Columbia-University-ZMBBI-AIC/LSD8-HW/README.md

# LSD8-HW
LED Synchronous Driver Hardware
