Columbia-University-ZMBBI-AIC/LSD8-HW/LEDSyncDRVG2-BOM_REVA.xlsx

 | REVA | LED Sync. Driver 8 Channels GEN2 |  | 2021-02-08
Qty | MPN | MNF | Parts | VALUE | DESCRIPTION | Package | CURRENT | POWER | TOLERANCE | VOLTAGE | VENDOR | Notes | DATASHEET
32 | 06035C104JAT2A | AVX | C1, C2, C3, C12, C13, C14, C18, C20, C101, C102, C103, C104, C108, C109, C201, C202, C203, C204, C208, C209, C301, C302, C303, C304, C308, C309, C401, C402, C403, C404, C408, C409 | 0.10uF | Multilayer Ceramic Capacitor (MLCC)X7R 0603, 0.10uF 5%, 50V | MLCC_0603 |  |  | 5% | 50V | Mouser |  | https://www.mouser.com/datasheet/2/40/X7RDielectric-777024.pdf
2 | VJ0603D100JXPAJ | Murata | C15, C16 | 10pF | Multilayer Ceramic Capacitor (MLCC)C0G HF 0603, 10pF 5%, 250V | MLCC_0603 |  |  | +/-0.05pF | 250V | Mouser |  | https://www.mouser.com/datasheet/2/427/vjhifreq-1391225.pdf
5 | GMK316AB7106KL-TR | TAIYO YUDEN | C4, C105, C205, C305, C405 | 10uF | Ceramic Capacitor X7R 1206 35V 10uF | MLCC_1206 |  |  |  | 35V | Mouser |  | https://componentsearchengine.com/Datasheets/1/TMK316AB7106KLHT.pdf
3 | CGA3E1X7R1V105K080AC | TDK | C5, C6, C17 | 1uF | Multilayer Ceramic Capacitor (MLCC)X7R 0603, 1uF 10%, 35V | MLCC_0603 |  |  | 10% | 35V | Mouser |  | https://www.mouser.com/datasheet/2/400/lcc_automotive_general_en-843974.pdf
1 | GCM1885C2A470FA16D | Murata | C7 | 47pF | Multilayer Ceramic Capacitor (MLCC)C0G HF 0603, 47pF 1%, 100V | MLCC_0603 |  |  | 1% | 100V | Mouser |  | https://psearch.en.murata.com/capacitor/lineup/gcm/?excid=ww_pa-o_ow_ctl_c02e-21_2017#a01
13 | 0603ZD106KAT2A | AVX | C8, C9, C10, C11, C19, C106, C107, C206, C207, C306, C307, C406, C407 | 10uF | Multilayer Ceramic Capacitor (MLCC)X5R 0603, 10uF 10%, 10V | MLCC_0603 |  |  | 10% | 10V | Mouser |  | https://www.mouser.com/datasheet/2/40/cx5r-776519.pdf
1 | MMSZ3V6T1G | ON Semi | D1 | 3.6V | ZENNER DIODE, 0.5W, 3.6V, SMT SOD123-2 | SOD3716X135N_DIODE | 100mA | 0.5W max |  |  | Mouser |  | https://www.mouser.com/datasheet/2/308/MMSZ2V4T1-D-87271.pdf
1 | NHP140SFT3G | ON Semi | D2 | NHP140 | Rectifier Diode 1A 400V. SOD−123FL | SOD-123FL | 1A | 330 degC/W |  |  | Mouser |  | https://www.onsemi.com/pub/Collateral/NHP140SF-D.PDF.pdf
1 | AP63200WU-7 | Diodes Inc. | IC1 | AP63200 | Switching Voltage Regulators DCDC Conv HV Buck TSOT26 | SOT95P280X100-6N |  |  |  |  | Mouser
12 | TLV2197QDGKRQ1 | Texas Instruments | IC101, IC104, IC105, IC201, IC204, IC205, IC301, IC304, IC305, IC401, IC404, IC405 | TLV2197 | 36-V, Single-Supply, 10-MHz, Rail-to-Rail IN&Output, Dual Operational Amplifier | VSSOP8-DGK-065P |  |  |  |  | Mouser |  | https://www.ti.com/lit/ds/symlink/tlv197-q1.pdf?ts=1595483432163
1 | TLV76733DGNR | TI | IC2 | TLV76733 | Precision Linear Voltage Regulator FIX 3.3V 1A 16V max in Drop 1.5V VSSOP PAD | VSSOP8-DGK-065P |  |  |  |  | Mouser |  | https://www.ti.com/lit/ds/symlink/tlv767.pdf?ts=1612309893782
10 | TC7WZ08FK | Toshiba | IC3, IC5, IC102, IC103, IC202, IC203, IC302, IC303, IC402, IC403 | TC7WZ08 | Logic Gates Dual AND in TSSOP | SOP50P310X90-8N |  |  |  |  | Mouser |  | https://toshiba.semicon-storage.com/info/docget.jsp?did=54672&prodName=TC7WZ08FK
1 | STM32F410CBT3 | STMicroelectronics | IC4 | STM32F410 | MCU STM32F410 Cortex M4 125DMips 128KBFlash, 32KB Ram, ADC/DAC, LQFP48 | QFP50P900X900X160-48N |  |  |  |  | Mouser |  | https://www.mouser.com/datasheet/2/389/stm32f410cb-1851313.pdf
1 | VLS5045EX-100M | TDK | L1 | 10uH | TDK VLS-EX Series Type 5045 Shielded Wire-wound SMD Inductor with a Ferrite Core, 10 uH Wire-Wound 2.5A Idc | IND_5X5MM-5045 |  |  |  |  | Mouser |  | https://componentsearchengine.com/Datasheets/1/VLS5045EX-100M.pdf
1 | CFM100M075 | Cincon | M1 | 7.5V 13.4A PS | OPEN FRAME 3X5 AC-DC PS MODULE WITH PFC ,100W MEDICAL&ITE, 7.5V 13.4A" | PS_5X3_MOLEX8P |  |  |  |  | Mouser |  | https://www.cincon.com/productdownload/SPEC-CFM100M-V19.pdf
8 | DMG6601LVT-7 | Diodes | Q101, Q102, Q201, Q202, Q301, Q302, Q401, Q402 | DMG6601 | Diodes Inc DMG6601LVT-7 Dual N/P-channel MOSFET, 2 A, 3A, 30 V, 6-Pin TSOT-26 | SOT95P280X100-6N |  |  |  |  | Mouser |  | https://www.diodes.com/assets/Datasheets/DMG6601LVT.pdf
8 | BSC12DN20NS3 G | Infineon | Q103, Q104, Q203, Q204, Q303, Q304, Q403, Q404 | BSC12DN20N | N CH MOSFET 200V, 11.3A, 125mOhm ON, 12S gfs, SMT TDSON-8 | TDSON-8 | 11.3A | 50W |  |  | Mouser |  | https://www.mouser.com/datasheet/2/196/BSC12DN20NS3%20Rev2.2-58027.pdf
1 | CRCW060356K0FKEA | Vishay | R1 | 56 kΩ | Thick Film Resistor 0603, 56 kΩ ,1%, 0.1W | R0603 |  | 0.1W | 1% |  | Mouser |  | http://www.vishay.com/docs/20035/dcrcwe3.pdf
8 | CRCW06034K30FKEA | Vishay | R103, R104, R203, R204, R303, R304, R403, R404 | 4.3 kΩ | Thick Film Resistor 0603, 4.3 kΩ ,1%, 0.1W | R0603 |  | 0.1W | 1% |  | Mouser |  | http://www.vishay.com/docs/20035/dcrcwe3.pdf
16 | CRCW060333R0FKEA | Vishay | R105, R106, R114, R115, R205, R206, R214, R215, R305, R306, R314, R315, R405, R406, R414, R415 | 33 Ω | Thick Film Resistor 0603, 33 Ω ,1%, 0.1W | R0603 |  | 0.1W | 1% |  | Mouser |  | http://www.vishay.com/docs/20035/dcrcwe3.pdf
8 | CRCW06033K30FKEA | Vishay | R107, R108, R207, R208, R307, R308, R407, R408 | 3.3 kΩ | Thick Film Resistor 0603, 3.3 kΩ ,1%, 0.1W | R0603 |  | 0.1W | 1% |  | Mouser |  | http://www.vishay.com/docs/20035/dcrcwe3.pdf
8 | 3006P-7-502LF | Bourns | R109, R110, R209, R210, R309, R310, R409, R410 | 5K | Multi Turn Resistor Long, Through Hole RA 5K 10% 3/4 " | MTBOURNS_RA_LONG |  |  |  |  | Mouser |  | https://www.mouser.com/datasheet/2/54/3006-1649234.pdf
8 | WK73S3A3TTE1R00F | KOA Speer | R116, R117, R216, R217, R316, R317, R416, R417 | 1 Ohm | Thick Film Resistor Reversed 1225 1 ohm 1% 3W | R1225 |  |  |  |  | Mouser |  | https://www.mouser.com/datasheet/2/219/WK73S-1840148.pdf
22 | CRCW060310K0FKEA | Vishay | R2, R4, R6, R10, R11, R12, R101, R102, R111, R112, R201, R202, R211, R212, R301, R302, R311, R312, R401, R402, R411, R412 | 10 kΩ | Thick Film Resistor 0603, 10 kΩ ,1%, 0.1W | R0603 |  | 0.1W | 1% |  | Mouser |  | http://www.vishay.com/docs/20035/dcrcwe3.pdf
4 | CRCW0603100RFKEA | Vishay | R3, R5, R7, R8 | 100 Ω | Thick Film Resistor 0603, 100 Ω ,1%, 0.1W | R0603 |  | 0.1W | 1% |  | Mouser |  | http://www.vishay.com/docs/20035/dcrcwe3.pdf
6 | CRCW06030000Z0EA | Vishay | R9, R13, R113, R213, R313, R413 | 0 Ω | Thick Film Resistor 0603, 0 Ω ,1%, 0.1W | R0603 |  |  |  |  | Mouser |  | http://www.vishay.com/docs/20035/dcrcwe3.pdf
1 | ECS-240-8-33-RWY-TR | ECS | Y1 | 24.0MHz | Crystal 3.2X2.5mm 24MHz 15ppm 8pF -30C +55C | XTAL4P_3.2X2.5MM |  |  |  |  | Mouser |  | https://www.mouser.com/datasheet/2/122/ecx-32-1100709.pdf
1 | 800SP9B6M6RE | E-Switch | S1 | SPST RA | Pushbutton Switch SPST RA PCB With Mounting NON-THD | SITCH_PB_RA_800SP9B6M6RE |  |  |  |  | Mouser |  | https://www.mouser.com/datasheet/2/140/800-345975.pdf
1 | DS03-254-08BE | CUI | S3 | DIP8-RA | DIP Switches SPST, 2.54 pitch, Raised actuator, RA, 8 position, Blue | SWITCHX8_DIP_RA_0.1IN | 25ma |  |  | 24V | Mouser |  | https://www.mouser.com/datasheet/2/670/ds03_254-1777715.pdf
1 | 70555-0072 | Molex | J1 | HDR 1X3 RA-M | Header RA Male 1X3 Gold Shrouded 0.1 " | HDR_1X3RAS | 3A |  |  |  | Mouser |  | https://www.mouser.com/datasheet/2/276/705550071_sd-1608181.pdf
8 | 1526169 | Phoenix | J103, J104, J203, J204, J303, J304, J403, J404 | 4P Thor LED RA | Circular 4 PIN Female RA Thor Led Pinout | CIR_PHX4P_RA |  |  |  |  | Mouser |  | https://www.mouser.com/datasheet/2/324/4/1526169-1415351.pdf
1 | 30310-5002HB | 3M | J2 | HDR 2X5 RA-M | Header RA Male 2X5 Gold Shrouded 0.1 " | HDR_2X5M_RAS | 1A |  |  |  | Mouser | Molex has replacement 70247-1054 | https://www.mouser.com/datasheet/2/1/TS0818-221281.pdf
9 | 5227161-6 | TE | J3, J101, J102, J201, J202, J301, J302, J401, J402 | RA BNC 50 Ohm | BNC R.A. JACK 50 OHM ISOLATED | BNC_AMP_227161 |  |  |  |  | Mouser |  | https://www.te.com/commerce/DocumentDelivery/DDEController?Action=srchrtrv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
2 | 77311-124-02LF | Amphenol FCI | J4, J5 | HDR 1x2 ST-M | Header Straight Male 1 X 2 (2.54mm square) 6.75mm post | HDR_1X2 | 3A |  |  |  | Mouser |  | https://www.mouser.com/datasheet/2/18/77311-1266344.pdf
1 | NHD-3.12-25664UCY2 | Newhaven Display | DS1 | OLED Display Yellow 256X64 | OLED Display 256 x 64 Yellow 89.2 x 44.0 x 6.0 3.0V | DISPLAY20P |  |  |  |  | Mouser |  | https://www.mouser.com/datasheet/2/291/NHD_3_12_25664UCY2-1902151.pdf
1 |  |  | R14 | NP | No Placed/Populated Resistor | R0603
1 |  |  | S2 | NP | Pushbutton Switch SPST RA PCB With Mounting NON-THD | SITCH_PB_RA_800SP9B6M6RE |  |  |  |  | Mouser |  | https://www.mouser.com/datasheet/2/140/800-345975.pdf
3 |  |  | J6,J7,J8 | NP | Header Straight Male 1 X 6 (2.54mm square) 6.75mm post | HDR_1X06 | 3A |  |  |  | Mouser |  | https://www.mouser.com/datasheet/2/18/77311-1266344.pdf
