Columbia-University-ZMBBI-AIC/LSD8-HW/Mechanic/dispBracket.stl

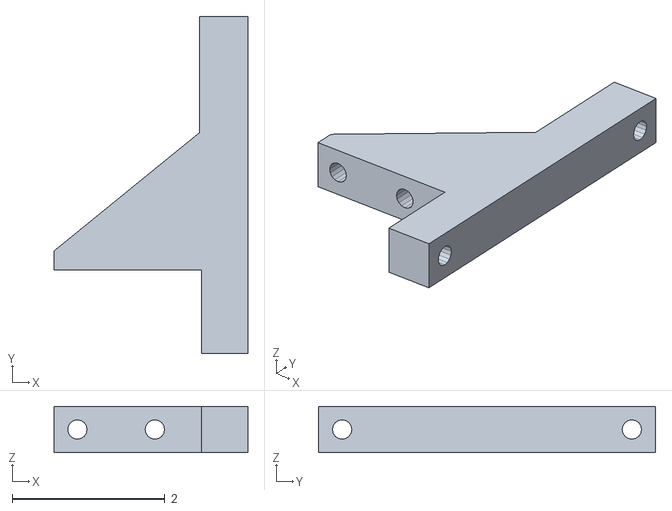
[picture p1: CAD file, 2022-06-25]
Mechanic/dispBracket.stl
2.54 x 4.42 x 0.61
