Columbia-University-ZMBBI-AIC/LSD8-HW/(list of files, cad)

Other CAD files:
Mechanic/dispBracket.ipt
