Columbia-University-ZMBBI-AIC/LSD8-HW/Mechanic/LEDSyncDRVG2-DimAIC00028REVA.pdf

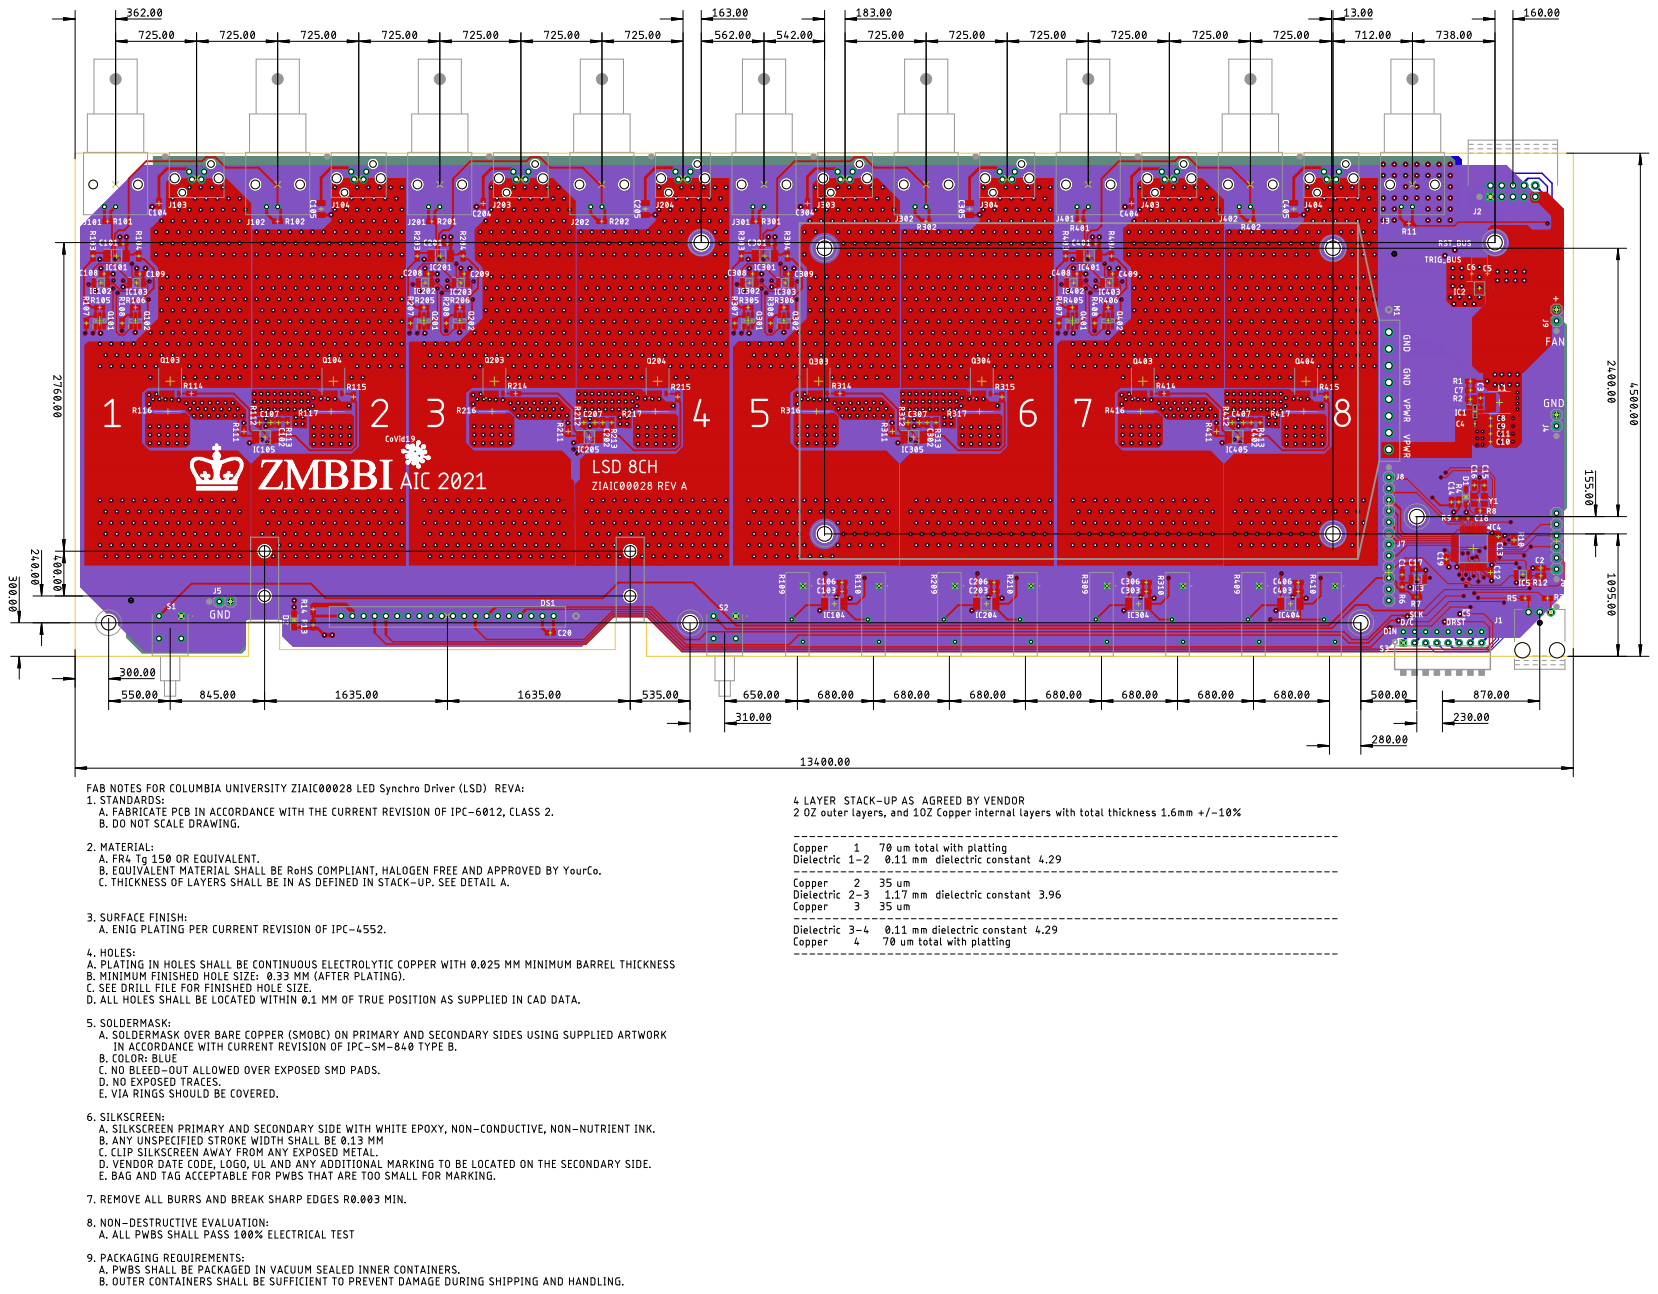
[picture p2: page 1]
