Columbia-University-ZMBBI-AIC/LSD8-HW/LEDSyncDRVG2.brd

## EAGLE design LEDSyncDRVG2.brd (2022-06-25)

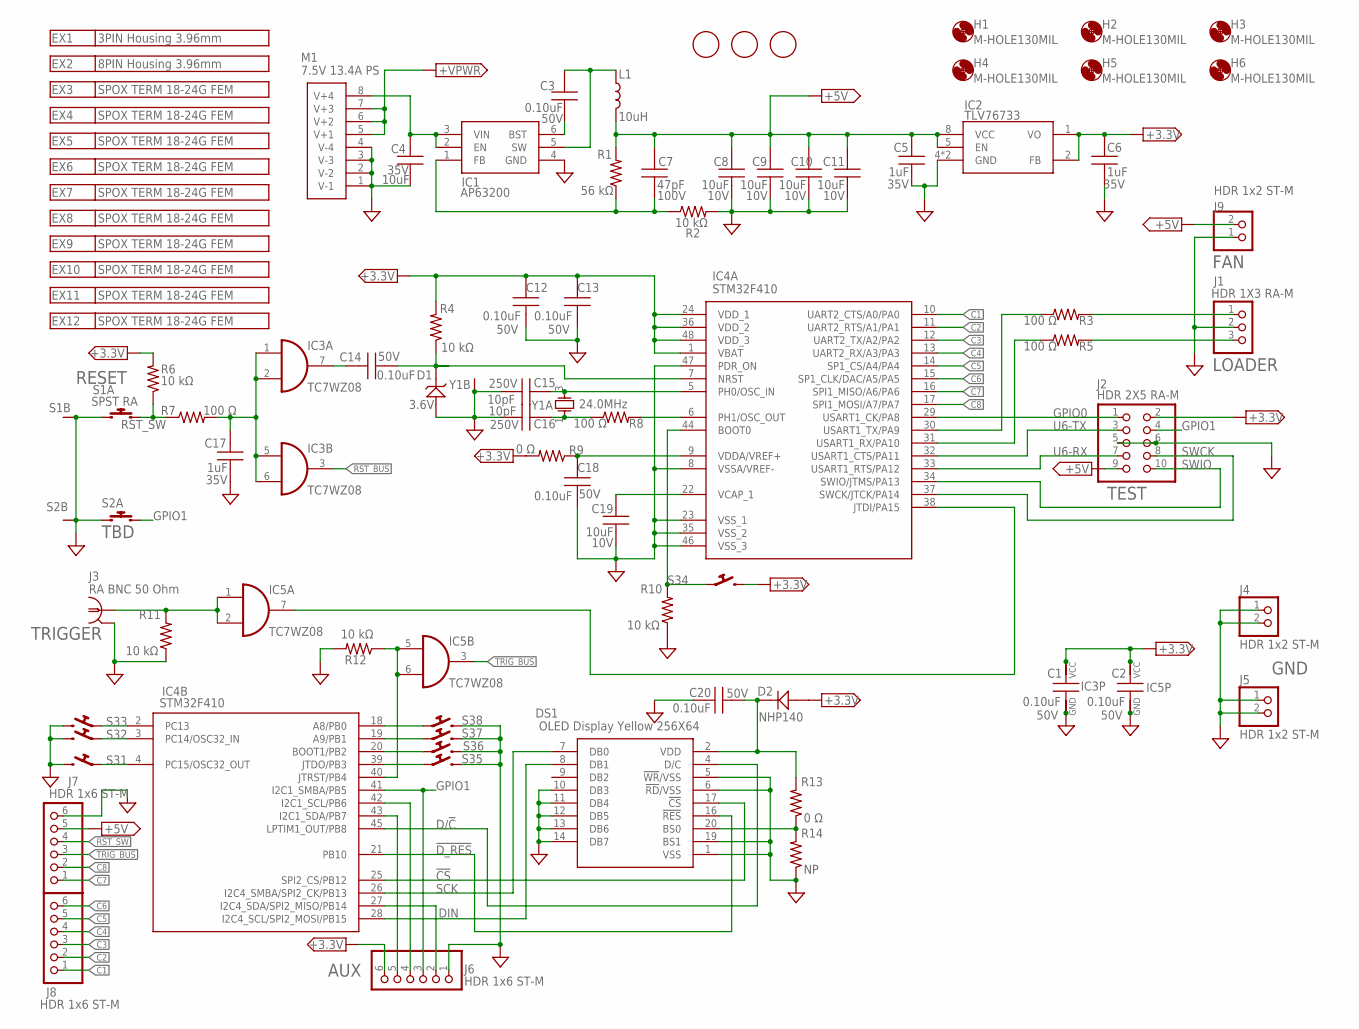
[picture p8: schematic LEDSyncDRVG2.sch, sheet 1]

Parts:
C1, C2, C3, C12, C13, C14, C18, C20: 0.10uF; MLCC_0603
C4: 10uF; MLCC_1206
C5, C6, C17: 1uF; MLCC_0603
C7: 47pF; MLCC_0603
C8, C9, C10, C11, C19: 10uF; MLCC_0603
C15, C16: 10pF; MLCC_0603
D1: 3.6V; SOD3716X135N_DIODE
D2: NHP140; SOD-123FL
DS1: OLED Display Yellow 256X64; DISPLAY20P
H1, H2, H3, H4, H5, H6: M-HOLE130MIL; 4-40_130HOLE_260CLEAR
IC1: AP63200; SOT95P280X100-6N
IC2: TLV76733; VSSOP8-DGK-065P
IC3, IC5: TC7WZ08; SOP50P310X90-8N
IC4: STM32F410; QFP50P900X900X160-48N
J1: HDR 1X3 RA-M; HDR_1X3RAS
J2: HDR 2X5 RA-M; HDR_2X5M_RAS
J3: RA BNC 50 Ohm; BNC_AMP_227161
J4, J5, J9: HDR 1x2 ST-M; HDR_1X2
J6: HDR 1x6 ST-M; HDR_1X06
J7, J8: HDR 1x6 ST-M; HDR_1X06; MPN NP
L1: 10uH; IND_5X5MM-5045
M1: 7.5V 13.4A PS; PS_5X3_MOLEX8P
R1: 56 kΩ; R0603
R2, R4, R6, R10, R11, R12: 10 kΩ; R0603
R3, R5, R7, R8: 100 Ω; R0603
R9, R13: 0 Ω; R0603
R14: NP; R0603
S1, S2: SPST RA; SITCH_PB_RA_800SP9B6M6RE
S3: DIP8-RA; SWITCHX8_DIP_RA_0.1IN
U$1, U$2, U$3: FIDUCIAL; FIDUCIAL_1MM
Y1: 24.0MHz; XTAL4P_3.2X2.5MM

Connections:
!CS: DS1.17 (!CS), IC4.25 (SPI2_CS/PB12)
!D_RES: DS1.16 (!RES), IC4.21 (PB10)
+3.3V: C1.2, C2.2, C6.1, C12.2, C13.2, D2.2 (A), IC2.1 (VO), IC2.2 (FB), IC3.8 (VCC), IC4.1 (VBAT), IC4.24 (VDD_1), IC4.36 (VDD_2), IC4.48 (VDD_3), IC5.8 (VCC), J2.2, J6.6, R4.2, R6.2, R9.2, S3.8; also elsewhere on the board
+5V: C5.1, C7.2, C8.2, C9.2, C10.2, C11.2, IC2.5 (EN), IC2.8 (VCC), J2.9, J7.5, J9.2, L1.2, R1.2; also elsewhere on the board
+VPWR: M1.5 (V+1), M1.6 (V+2), M1.7 (V+3); also elsewhere on the board
C1: IC4.10 (UART2_CTS/A0/PA0), J8.1; also elsewhere on the board
C2: IC4.11 (UART2_RTS/A1/PA1), J8.2; also elsewhere on the board
C3: IC4.12 (UART2_TX/A2/PA2), J8.3; also elsewhere on the board
C4: IC4.13 (UART2_RX/A3/PA3), J8.4; also elsewhere on the board
C5: IC4.14 (SP1_CS/A4/PA4), J8.5; also elsewhere on the board
C6: IC4.15 (SP1_CLK/DAC/A5/PA5), J8.6; also elsewhere on the board
C7: IC4.16 (SPI1_MISO/A6/PA6), J7.1; also elsewhere on the board
C8: IC4.17 (SPI1_MOSI/A7/PA7), J7.2; also elsewhere on the board
D/!C: DS1.4 (D/C), IC4.45 (LPTIM1_OUT/PB8)
DIN: DS1.8 (DB1), IC4.28 (I2C4_SCL/SPI2_MOSI/PB15)
GND: C1.1, C2.1, C4.2, C5.2, C6.2, C8.1, C9.1, C10.1, C11.1, C12.1, C13.1, C15.1, C16.1, C17.2, C18.1, C19.1, C20.2, D1.2 (A), DS1.1 (VSS), DS1.5 (!WR!/VSS), DS1.6 (!RD!/VSS), DS1.10 (DB3), DS1.11 (DB4), DS1.12 (DB5), DS1.13 (DB6), DS1.14 (DB7), DS1.19 (BS1), IC1.4 (GND), IC2.4 (GND), IC2.6 (GND), IC3.4 (GND), IC4.8 (VSSA/VREF-), IC4.23 (VSS_1), IC4.35 (VSS_2), IC4.46 (VSS_3), IC4.47 (PDR_ON), IC5.4 (GND), J1.2, J2.5, J2.6, J3.2, J4.1, J4.2, J5.1, J5.2, J6.1, J7.6, J9.1, M1.1 (V-1), M1.2 (V-2), M1.3 (V-3), M1.4 (V-4), R2.2, R10.1, R11.1, R12.2, R14.1, S1.1, S1.MH1 (G1), S1.MH2 (G1), S2.1, S2.MH1 (G1), S2.MH2 (G1), S3.2, S3.4, S3.6, S3.10, S3.12, S3.14, S3.16, Y1.2 (G1), Y1.4 (G1); also elsewhere on the board
GPIO0: IC4.29 (USART1_CK/PA8), J2.1
GPIO1: IC4.41 (I2C1_SMBA/PB5), J2.4, J6.3, S2.3
unnamed: C4.1, IC1.2 (EN), IC1.3 (VIN), M1.8 (V+4)
unnamed: IC4.6 (PH1/OSC_OUT), R8.2
unnamed: C16.2, R8.1, Y1.1 (IO)
unnamed: C15.2, IC4.5 (PH0/OSC_IN), Y1.3 (OI)
unnamed: C18.2, IC4.9 (VDDA/VREF+), R9.1
unnamed: IC4.3 (PC14/OSC32_IN), S3.3
unnamed: C19.2, IC4.22 (VCAP_1)
unnamed: IC4.44 (BOOT0), R10.2, S3.7
unnamed: C14.1, D1.1 (K), IC4.7 (NRST), R4.1
unnamed: C3.2, IC1.5 (SW), L1.1
unnamed: C7.1, IC1.1 (FB), R1.1, R2.1
unnamed: C3.1, IC1.6 (BST)
unnamed: IC4.18 (A8/PB0), S3.15
unnamed: IC4.19 (A9/PB1), S3.13
unnamed: J1.3, R5.2
unnamed: J1.1, R3.2
unnamed: IC4.20 (BOOT1/PB2), S3.11
unnamed: IC4.39 (JTDO/PB3), S3.9
unnamed: IC4.2 (PC13), S3.5
unnamed: DS1.20 (BS0), R13.1, R14.2
unnamed: IC4.4 (PC15/OSC32_OUT), S3.1
unnamed: IC4.38 (JTDI/PA15), IC5.7 (O)
unnamed: C20.1, D2.1 (K), DS1.2 (VDD), R13.2
unnamed: IC4.27 (I2C4_SDA/SPI2_MISO/PB14), J6.2
unnamed: IC4.30 (USART1_TX/PA9), R3.1
unnamed: IC4.43 (I2C1_SDA/PB7), J6.5
unnamed: IC4.42 (I2C1_SCL/PB6), J6.4
unnamed: C14.2, IC3.7 (O)
unnamed: IC4.31 (USART1_RX/PA10), R5.1
unnamed: IC4.40 (JTRST/PB4), IC5.5 (I0), IC5.6 (I1), R12.1
unnamed: IC5.1 (I0), IC5.2 (I1), J3.1, R11.2
RST: C17.1, IC3.1 (I0), IC3.2 (I1), IC3.5 (I0), IC3.6 (I1), R7.2
RST_BUS: IC3.3 (O); also elsewhere on the board
RST_SW: J7.4, R6.1, R7.1, S1.3
SCK: DS1.7 (DB0), IC4.26 (I2C4_SMBA/SPI2_CK/PB13)
SWCK: IC4.37 (SWCK/JTCK/PA14), J2.8
SWIO: IC4.34 (SWIO/JTMS/PA13), J2.10
TRIG_BUS: IC5.3 (O), J7.3; also elsewhere on the board
U6-RX: IC4.33 (USART1_RTS/PA12), J2.7
U6-TX: IC4.32 (USART1_CTS/PA11), J2.3

Notes on the sheet:
TEST
AUX
LOADER
TRIGGER
GND
RESET
TBD
FAN

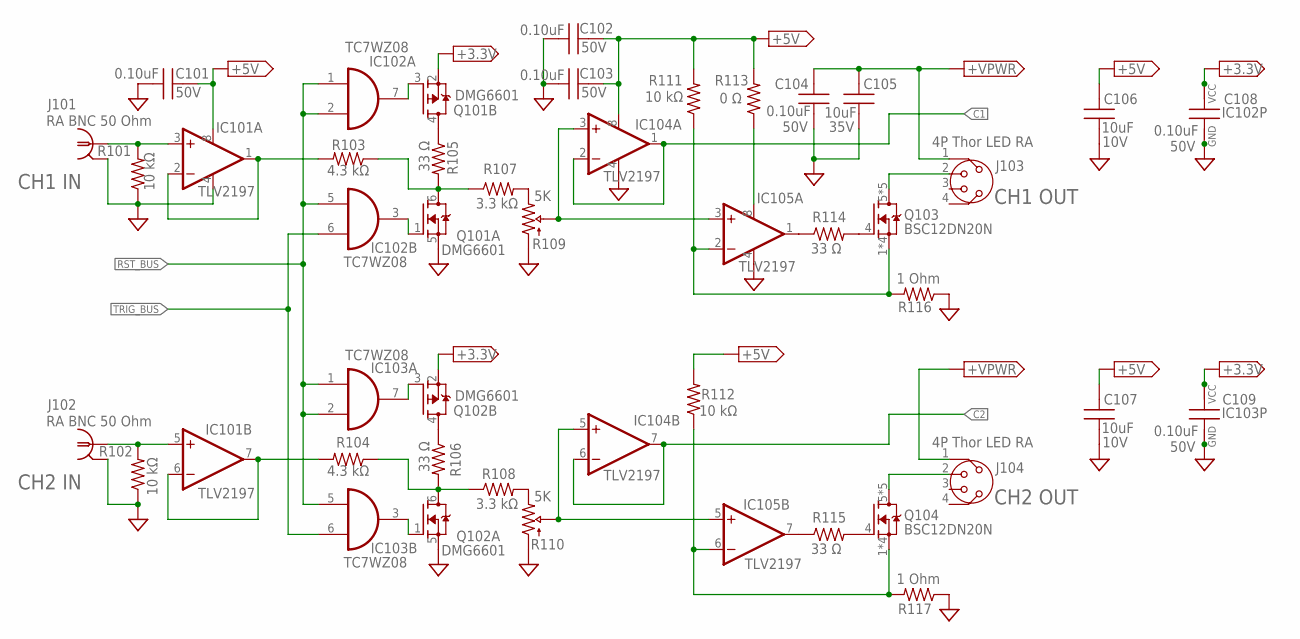
[picture p9: schematic LEDSyncDRVG2.sch, sheet 2]

Parts:
C101, C102, C103, C104, C108, C109: 0.10uF; MLCC_0603
C105: 10uF; MLCC_1206
C106, C107: 10uF; MLCC_0603
IC101, IC104, IC105: TLV2197; VSSOP8-DGK-065P
IC102, IC103: TC7WZ08; SOP50P310X90-8N
J101, J102: RA BNC 50 Ohm; BNC_AMP_227161
J103, J104: 4P Thor LED RA; CIR_PHX4P_RA
Q101, Q102: DMG6601; SOT95P280X100-6N
Q103, Q104: BSC12DN20N; TDSON-8
R101, R102, R111, R112: 10 kΩ; R0603
R103, R104: 4.3 kΩ; R0603
R105, R106, R114, R115: 33 Ω; R0603
R107, R108: 3.3 kΩ; R0603
R109, R110: 5K; MTBOURNS_RA_LONG
R113: 0 Ω; R0603
R116, R117: 1 Ohm; R1225

Connections:
+3.3V: C108.2, C109.2, IC102.8 (VCC), IC103.8 (VCC), Q101.2 (S), Q102.2 (S); also elsewhere on the board
+5V: C101.2, C102.2, C103.2, C106.2, C107.2, IC101.8 (V+), IC104.8 (V+), R111.2, R112.2, R113.2; also elsewhere on the board
+VPWR: C104.2, C105.1, J103.1, J104.1; also elsewhere on the board
C1: IC104.1 (OUT), IC104.2 (-IN); also elsewhere on the board
C2: IC104.6 (-IN), IC104.7 (OUT); also elsewhere on the board
GND: C101.1, C102.1, C103.1, C104.1, C105.2, C106.1, C107.1, C108.1, C109.1, IC101.4 (V-), IC102.4 (GND), IC103.4 (GND), IC104.4 (V-), IC105.4 (V-), J101.2, J102.2, Q101.5 (S), Q102.5 (S), R101.1, R102.1, R109.1 (START), R110.1 (START), R116.1, R117.1; also elsewhere on the board
unnamed: Q102.4 (D), R106.1
unnamed: Q101.4 (D), R105.1
unnamed: Q101.6 (D), R103.1, R105.2, R107.1
unnamed: IC102.3 (O), Q101.1 (G)
unnamed: IC102.7 (O), Q101.3 (G)
unnamed: IC101.1 (OUT), IC101.2 (-IN), R103.2
unnamed: IC101.3 (+IN), J101.1, R101.2
unnamed: R107.2, R109.3 (END)
unnamed: Q102.6 (D), R104.1, R106.2, R108.1
unnamed: IC104.3 (+IN), IC105.3 (+IN), R109.2 (WIPER)
unnamed: IC105.1 (OUT), R114.1
unnamed: IC105.2 (-IN), Q103.1 (S), Q103.2 (S), Q103.3 (S), Q103.10 (S), R111.1, R116.2
unnamed: Q103.4 (G), R114.2
unnamed: IC103.3 (O), Q102.1 (G)
unnamed: J103.2, Q103.5 (D), Q103.6 (D), Q103.7 (D), Q103.8 (D), Q103.9 (D)
unnamed: IC103.7 (O), Q102.3 (G)
unnamed: IC101.5 (+IN), J102.1, R102.2
unnamed: IC101.6 (-IN), IC101.7 (OUT), R104.2
unnamed: R108.2, R110.3 (END)
unnamed: IC104.5 (+IN), IC105.5 (+IN), R110.2 (WIPER)
unnamed: IC105.6 (-IN), Q104.1 (S), Q104.2 (S), Q104.3 (S), Q104.10 (S), R112.1, R117.2
unnamed: IC105.7 (OUT), R115.1
unnamed: Q104.4 (G), R115.2
unnamed: J104.2, Q104.5 (D), Q104.6 (D), Q104.7 (D), Q104.8 (D), Q104.9 (D)
unnamed: IC105.8 (V+), R113.1
RST_BUS: IC102.1 (I0), IC102.2 (I1), IC102.5 (I0), IC103.1 (I0), IC103.2 (I1), IC103.5 (I0); also elsewhere on the board
TRIG_BUS: IC102.6 (I1), IC103.6 (I1); also elsewhere on the board

Notes on the sheet:
CH1 IN
CH2 IN
CH1 OUT
CH2 OUT

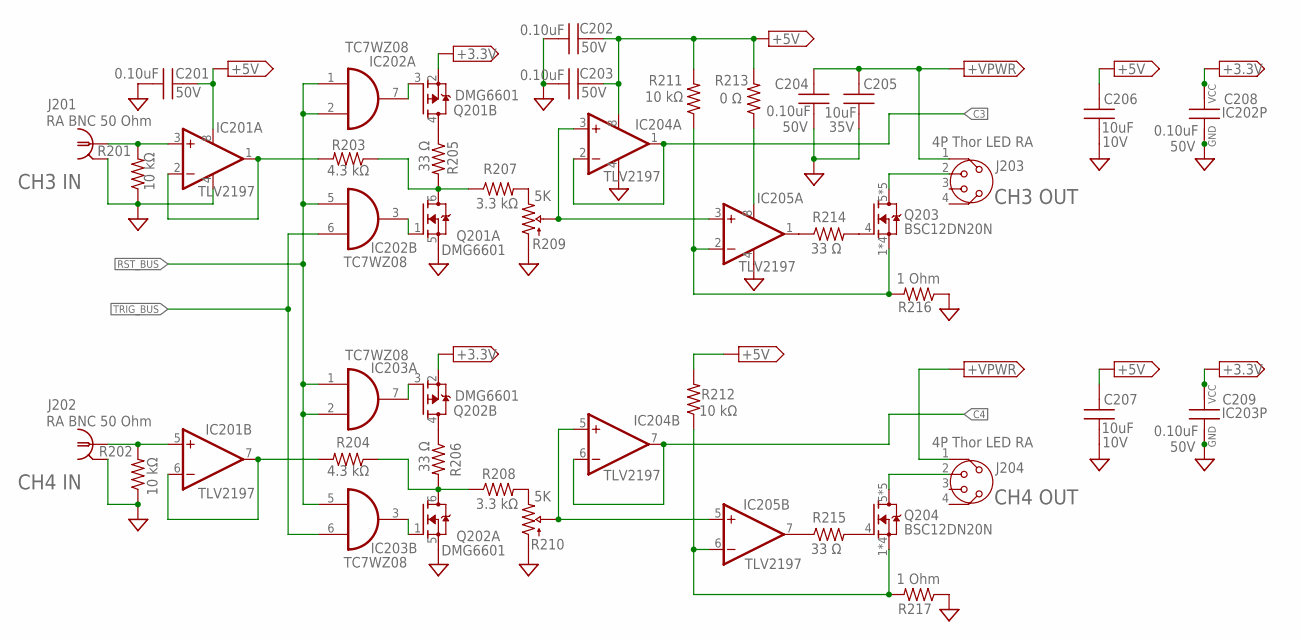
[picture p10: schematic LEDSyncDRVG2.sch, sheet 3]

Parts:
C201, C202, C203, C204, C208, C209: 0.10uF; MLCC_0603
C205: 10uF; MLCC_1206
C206, C207: 10uF; MLCC_0603
IC201, IC204, IC205: TLV2197; VSSOP8-DGK-065P
IC202, IC203: TC7WZ08; SOP50P310X90-8N
J201, J202: RA BNC 50 Ohm; BNC_AMP_227161
J203, J204: 4P Thor LED RA; CIR_PHX4P_RA
Q201, Q202: DMG6601; SOT95P280X100-6N
Q203, Q204: BSC12DN20N; TDSON-8
R201, R202, R211, R212: 10 kΩ; R0603
R203, R204: 4.3 kΩ; R0603
R205, R206, R214, R215: 33 Ω; R0603
R207, R208: 3.3 kΩ; R0603
R209, R210: 5K; MTBOURNS_RA_LONG
R213: 0 Ω; R0603
R216, R217: 1 Ohm; R1225

Connections:
+3.3V: C208.2, C209.2, IC202.8 (VCC), IC203.8 (VCC), Q201.2 (S), Q202.2 (S); also elsewhere on the board
+5V: C201.2, C202.2, C203.2, C206.2, C207.2, IC201.8 (V+), IC204.8 (V+), R211.2, R212.2, R213.2; also elsewhere on the board
+VPWR: C204.2, C205.1, J203.1, J204.1; also elsewhere on the board
C3: IC204.1 (OUT), IC204.2 (-IN); also elsewhere on the board
C4: IC204.6 (-IN), IC204.7 (OUT); also elsewhere on the board
GND: C201.1, C202.1, C203.1, C204.1, C205.2, C206.1, C207.1, C208.1, C209.1, IC201.4 (V-), IC202.4 (GND), IC203.4 (GND), IC204.4 (V-), IC205.4 (V-), J201.2, J202.2, Q201.5 (S), Q202.5 (S), R201.1, R202.1, R209.1 (START), R210.1 (START), R216.1, R217.1; also elsewhere on the board
unnamed: Q201.4 (D), R205.1
unnamed: Q201.6 (D), R203.1, R205.2, R207.1
unnamed: IC202.3 (O), Q201.1 (G)
unnamed: IC202.7 (O), Q201.3 (G)
unnamed: IC201.3 (+IN), J201.1, R201.2
unnamed: IC201.1 (OUT), IC201.2 (-IN), R203.2
unnamed: R207.2, R209.3 (END)
unnamed: IC204.3 (+IN), IC205.3 (+IN), R209.2 (WIPER)
unnamed: IC205.2 (-IN), Q203.1 (S), Q203.2 (S), Q203.3 (S), Q203.10 (S), R211.1, R216.2
unnamed: IC205.1 (OUT), R214.1
unnamed: Q203.4 (G), R214.2
unnamed: J203.2, Q203.5 (D), Q203.6 (D), Q203.7 (D), Q203.8 (D), Q203.9 (D)
unnamed: Q202.4 (D), R206.1
unnamed: Q202.6 (D), R204.1, R206.2, R208.1
unnamed: IC203.3 (O), Q202.1 (G)
unnamed: IC203.7 (O), Q202.3 (G)
unnamed: IC201.5 (+IN), J202.1, R202.2
unnamed: IC201.6 (-IN), IC201.7 (OUT), R204.2
unnamed: R208.2, R210.3 (END)
unnamed: IC204.5 (+IN), IC205.5 (+IN), R210.2 (WIPER)
unnamed: IC205.6 (-IN), Q204.1 (S), Q204.2 (S), Q204.3 (S), Q204.10 (S), R212.1, R217.2
unnamed: Q204.4 (G), R215.2
unnamed: J204.2, Q204.5 (D), Q204.6 (D), Q204.7 (D), Q204.8 (D), Q204.9 (D)
unnamed: IC205.7 (OUT), R215.1
unnamed: IC205.8 (V+), R213.1
RST_BUS: IC202.1 (I0), IC202.2 (I1), IC202.5 (I0), IC203.1 (I0), IC203.2 (I1), IC203.5 (I0); also elsewhere on the board
TRIG_BUS: IC202.6 (I1), IC203.6 (I1); also elsewhere on the board

Notes on the sheet:
CH3 IN
CH4 IN
CH3 OUT
CH4 OUT

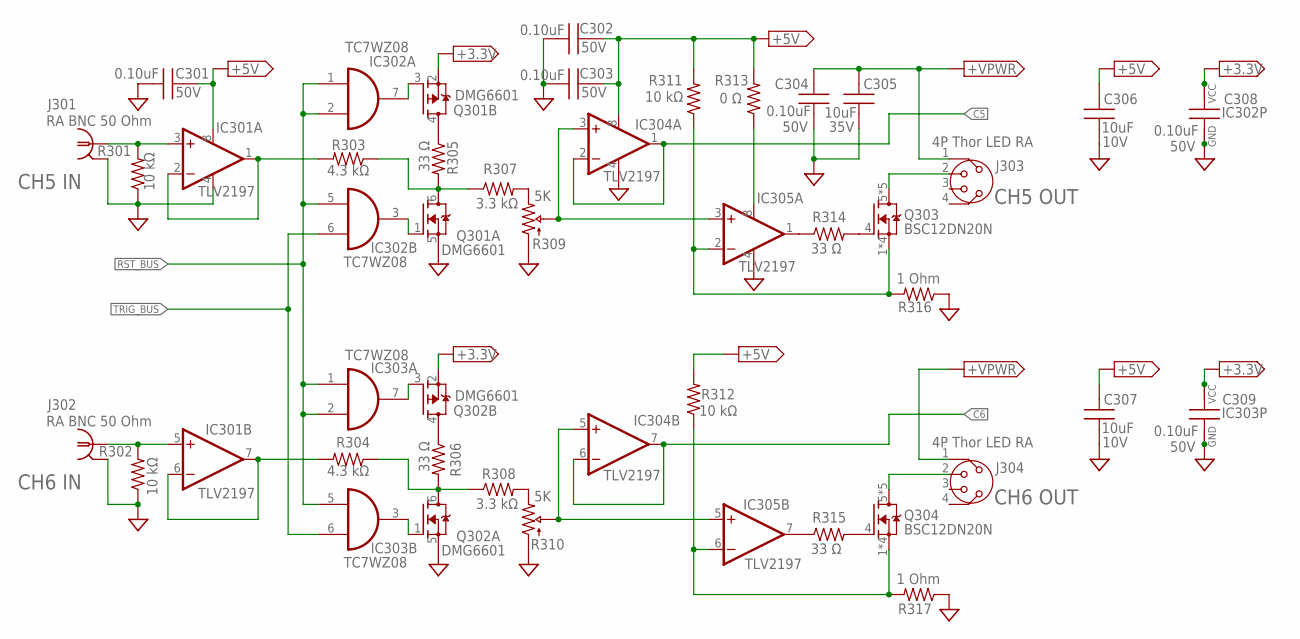
[picture p11: schematic LEDSyncDRVG2.sch, sheet 4]

Parts:
C301, C302, C303, C304, C308, C309: 0.10uF; MLCC_0603
C305: 10uF; MLCC_1206
C306, C307: 10uF; MLCC_0603
IC301, IC304, IC305: TLV2197; VSSOP8-DGK-065P
IC302, IC303: TC7WZ08; SOP50P310X90-8N
J301, J302: RA BNC 50 Ohm; BNC_AMP_227161
J303, J304: 4P Thor LED RA; CIR_PHX4P_RA
Q301, Q302: DMG6601; SOT95P280X100-6N
Q303, Q304: BSC12DN20N; TDSON-8
R301, R302, R311, R312: 10 kΩ; R0603
R303, R304: 4.3 kΩ; R0603
R305, R306, R314, R315: 33 Ω; R0603
R307, R308: 3.3 kΩ; R0603
R309, R310: 5K; MTBOURNS_RA_LONG
R313: 0 Ω; R0603
R316, R317: 1 Ohm; R1225

Connections:
+3.3V: C308.2, C309.2, IC302.8 (VCC), IC303.8 (VCC), Q301.2 (S), Q302.2 (S); also elsewhere on the board
+5V: C301.2, C302.2, C303.2, C306.2, C307.2, IC301.8 (V+), IC304.8 (V+), R311.2, R312.2, R313.2; also elsewhere on the board
+VPWR: C304.2, C305.1, J303.1, J304.1; also elsewhere on the board
C5: IC304.1 (OUT), IC304.2 (-IN); also elsewhere on the board
C6: IC304.6 (-IN), IC304.7 (OUT); also elsewhere on the board
GND: C301.1, C302.1, C303.1, C304.1, C305.2, C306.1, C307.1, C308.1, C309.1, IC301.4 (V-), IC302.4 (GND), IC303.4 (GND), IC304.4 (V-), IC305.4 (V-), J301.2, J302.2, Q301.5 (S), Q302.5 (S), R301.1, R302.1, R309.1 (START), R310.1 (START), R316.1, R317.1; also elsewhere on the board
unnamed: Q301.4 (D), R305.1
unnamed: Q301.6 (D), R303.1, R305.2, R307.1
unnamed: IC302.3 (O), Q301.1 (G)
unnamed: IC302.7 (O), Q301.3 (G)
unnamed: IC301.3 (+IN), J301.1, R301.2
unnamed: IC301.1 (OUT), IC301.2 (-IN), R303.2
unnamed: R307.2, R309.3 (END)
unnamed: IC304.3 (+IN), IC305.3 (+IN), R309.2 (WIPER)
unnamed: IC305.2 (-IN), Q303.1 (S), Q303.2 (S), Q303.3 (S), Q303.10 (S), R311.1, R316.2
unnamed: IC305.1 (OUT), R314.1
unnamed: Q303.4 (G), R314.2
unnamed: J303.2, Q303.5 (D), Q303.6 (D), Q303.7 (D), Q303.8 (D), Q303.9 (D)
unnamed: Q302.4 (D), R306.1
unnamed: Q302.6 (D), R304.1, R306.2, R308.1
unnamed: IC303.3 (O), Q302.1 (G)
unnamed: IC303.7 (O), Q302.3 (G)
unnamed: IC301.5 (+IN), J302.1, R302.2
unnamed: IC301.6 (-IN), IC301.7 (OUT), R304.2
unnamed: R308.2, R310.3 (END)
unnamed: IC304.5 (+IN), IC305.5 (+IN), R310.2 (WIPER)
unnamed: IC305.6 (-IN), Q304.1 (S), Q304.2 (S), Q304.3 (S), Q304.10 (S), R312.1, R317.2
unnamed: Q304.4 (G), R315.2
unnamed: J304.2, Q304.5 (D), Q304.6 (D), Q304.7 (D), Q304.8 (D), Q304.9 (D)
unnamed: IC305.7 (OUT), R315.1
unnamed: IC305.8 (V+), R313.1
RST_BUS: IC302.1 (I0), IC302.2 (I1), IC302.5 (I0), IC303.1 (I0), IC303.2 (I1), IC303.5 (I0); also elsewhere on the board
TRIG_BUS: IC302.6 (I1), IC303.6 (I1); also elsewhere on the board

Notes on the sheet:
CH5 IN
CH6 IN
CH5 OUT
CH6 OUT

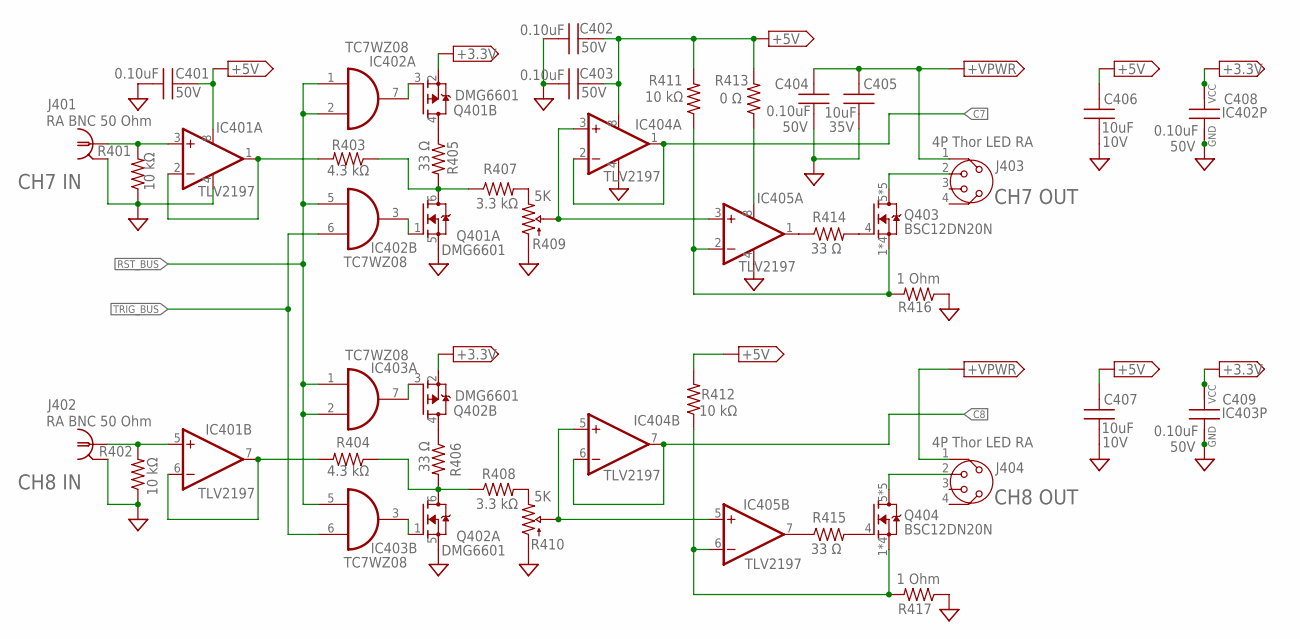
[picture p12: schematic LEDSyncDRVG2.sch, sheet 5]

Parts:
C401, C402, C403, C404, C408, C409: 0.10uF; MLCC_0603
C405: 10uF; MLCC_1206
C406, C407: 10uF; MLCC_0603
IC401, IC404, IC405: TLV2197; VSSOP8-DGK-065P
IC402, IC403: TC7WZ08; SOP50P310X90-8N
J401, J402: RA BNC 50 Ohm; BNC_AMP_227161
J403, J404: 4P Thor LED RA; CIR_PHX4P_RA
Q401, Q402: DMG6601; SOT95P280X100-6N
Q403, Q404: BSC12DN20N; TDSON-8
R401, R402, R411, R412: 10 kΩ; R0603
R403, R404: 4.3 kΩ; R0603
R405, R406, R414, R415: 33 Ω; R0603
R407, R408: 3.3 kΩ; R0603
R409, R410: 5K; MTBOURNS_RA_LONG
R413: 0 Ω; R0603
R416, R417: 1 Ohm; R1225

Connections:
+3.3V: C408.2, C409.2, IC402.8 (VCC), IC403.8 (VCC), Q401.2 (S), Q402.2 (S); also elsewhere on the board
+5V: C401.2, C402.2, C403.2, C406.2, C407.2, IC401.8 (V+), IC404.8 (V+), R411.2, R412.2, R413.2; also elsewhere on the board
+VPWR: C404.2, C405.1, J403.1, J404.1; also elsewhere on the board
C7: IC404.1 (OUT), IC404.2 (-IN); also elsewhere on the board
C8: IC404.6 (-IN), IC404.7 (OUT); also elsewhere on the board
GND: C401.1, C402.1, C403.1, C404.1, C405.2, C406.1, C407.1, C408.1, C409.1, IC401.4 (V-), IC402.4 (GND), IC403.4 (GND), IC404.4 (V-), IC405.4 (V-), J401.2, J402.2, Q401.5 (S), Q402.5 (S), R401.1, R402.1, R409.1 (START), R410.1 (START), R416.1, R417.1; also elsewhere on the board
unnamed: Q401.4 (D), R405.1
unnamed: Q401.6 (D), R403.1, R405.2, R407.1
unnamed: IC402.3 (O), Q401.1 (G)
unnamed: IC402.7 (O), Q401.3 (G)
unnamed: IC401.3 (+IN), J401.1, R401.2
unnamed: IC401.1 (OUT), IC401.2 (-IN), R403.2
unnamed: R407.2, R409.3 (END)
unnamed: IC404.3 (+IN), IC405.3 (+IN), R409.2 (WIPER)
unnamed: IC405.2 (-IN), Q403.1 (S), Q403.2 (S), Q403.3 (S), Q403.10 (S), R411.1, R416.2
unnamed: IC405.1 (OUT), R414.1
unnamed: Q403.4 (G), R414.2
unnamed: J403.2, Q403.5 (D), Q403.6 (D), Q403.7 (D), Q403.8 (D), Q403.9 (D)
unnamed: Q402.4 (D), R406.1
unnamed: Q402.6 (D), R404.1, R406.2, R408.1
unnamed: IC403.3 (O), Q402.1 (G)
unnamed: IC403.7 (O), Q402.3 (G)
unnamed: IC401.5 (+IN), J402.1, R402.2
unnamed: IC401.6 (-IN), IC401.7 (OUT), R404.2
unnamed: R408.2, R410.3 (END)
unnamed: IC404.5 (+IN), IC405.5 (+IN), R410.2 (WIPER)
unnamed: IC405.6 (-IN), Q404.1 (S), Q404.2 (S), Q404.3 (S), Q404.10 (S), R412.1, R417.2
unnamed: Q404.4 (G), R415.2
unnamed: J404.2, Q404.5 (D), Q404.6 (D), Q404.7 (D), Q404.8 (D), Q404.9 (D)
unnamed: IC405.7 (OUT), R415.1
unnamed: IC405.8 (V+), R413.1
RST_BUS: IC402.1 (I0), IC402.2 (I1), IC402.5 (I0), IC403.1 (I0), IC403.2 (I1), IC403.5 (I0); also elsewhere on the board
TRIG_BUS: IC402.6 (I1), IC403.6 (I1); also elsewhere on the board

Notes on the sheet:
CH7 IN
CH8 IN
CH7 OUT
CH8 OUT

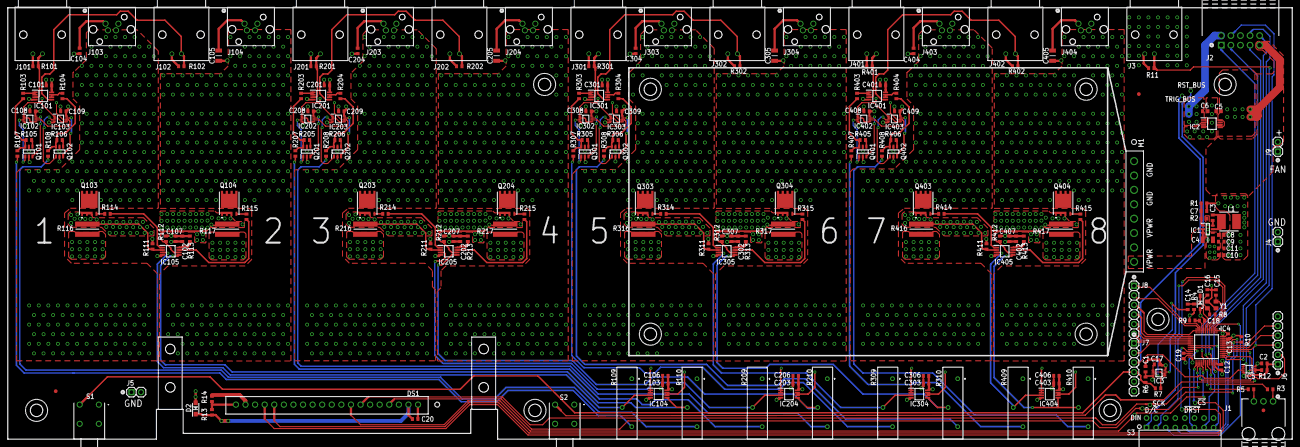
[picture p13: board LEDSyncDRVG2.brd from above]

Board: 4 copper layers, 340.4 x 114.3 mm, 222 parts (0 on the bottom side), 158 nets.
